podly/AlphaScore/hardware/AlphaScore - Modular PCB - 28PIN-SOP (300mil)/controller - back.png

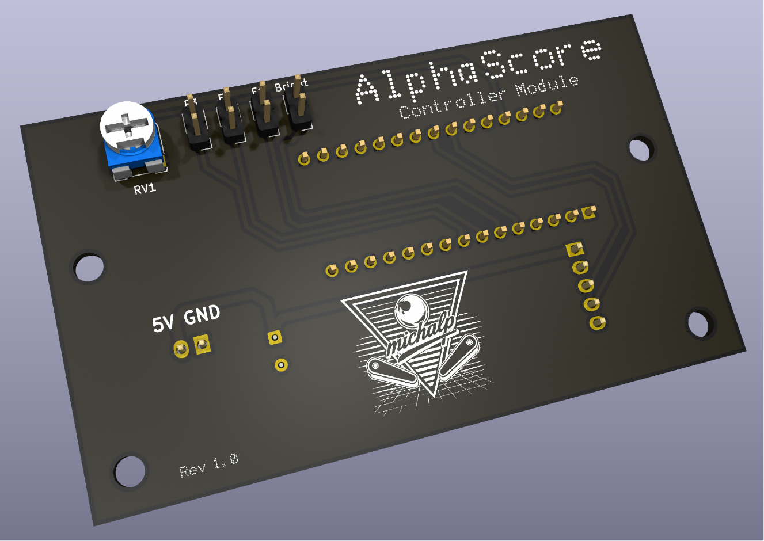
hardware/AlphaScore - Modular PCB - 28PIN-SOP (300mil)/controller - back.png
