podly/AlphaScore/hardware/AlphaScore - Modular PCB - 28PIN-SOP (300mil)/controller - front.png

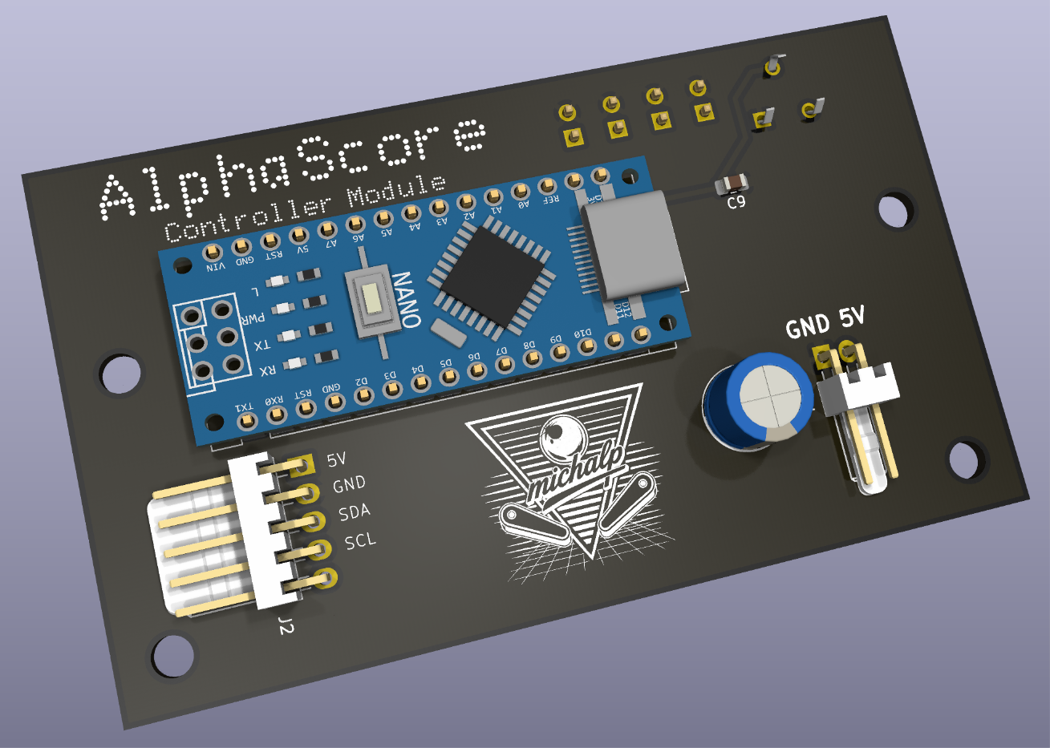
hardware/AlphaScore - Modular PCB - 28PIN-SOP (300mil)/controller - front.png
