podly/AlphaScore/hardware/AlphaScore - Modular PCB - 28PIN-SOP (300mil)/LED module - back.png

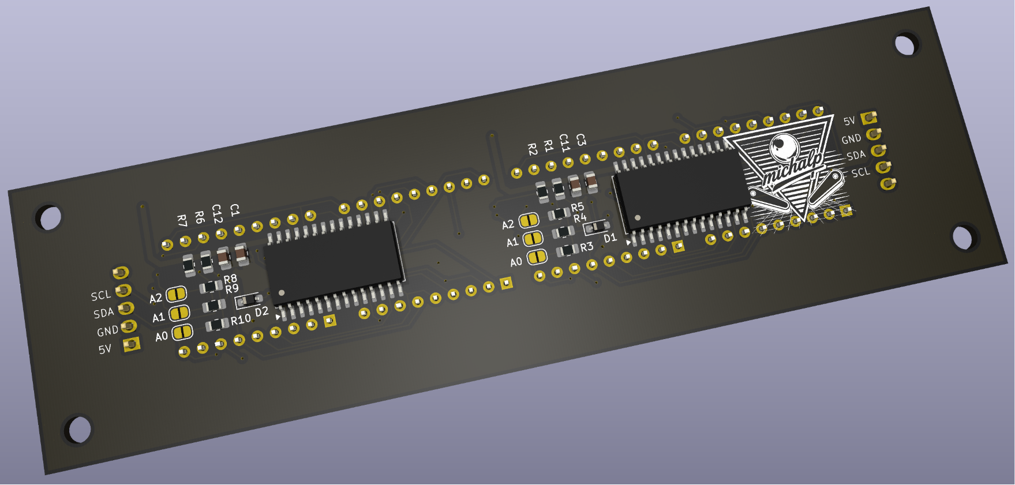
hardware/AlphaScore - Modular PCB - 28PIN-SOP (300mil)/LED module - back.png
