podly/AlphaScore/hardware/AlphaScore - Modular PCB - 28PIN-SOP (300mil)/LED module - front.png

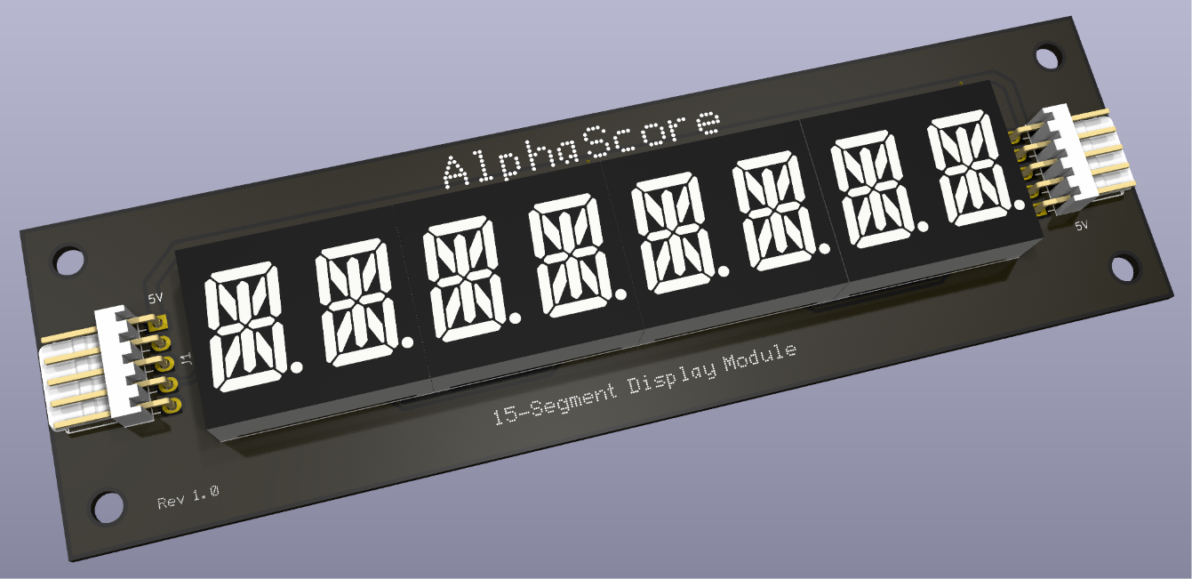
hardware/AlphaScore - Modular PCB - 28PIN-SOP (300mil)/LED module - front.png
