podly/AlphaScore/hardware/AlphaScore - Wide PCB - 28PIN-SOP (300mil)/Wide PCB - SOP28 (300mil) - back.png

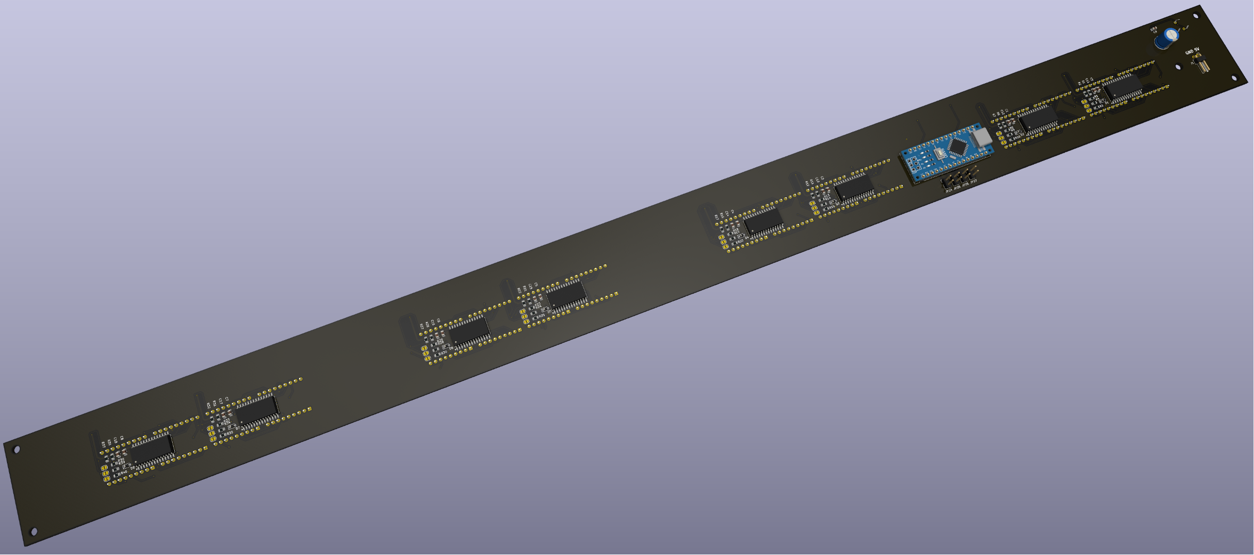
hardware/AlphaScore - Wide PCB - 28PIN-SOP (300mil)/Wide PCB - SOP28 (300mil) - back.png
