podly/AlphaScore/hardware/AlphaScore - Modular PCB - 28PIN-SOP (300mil)/AlphaScore - Modular PCB - controller module.pdf

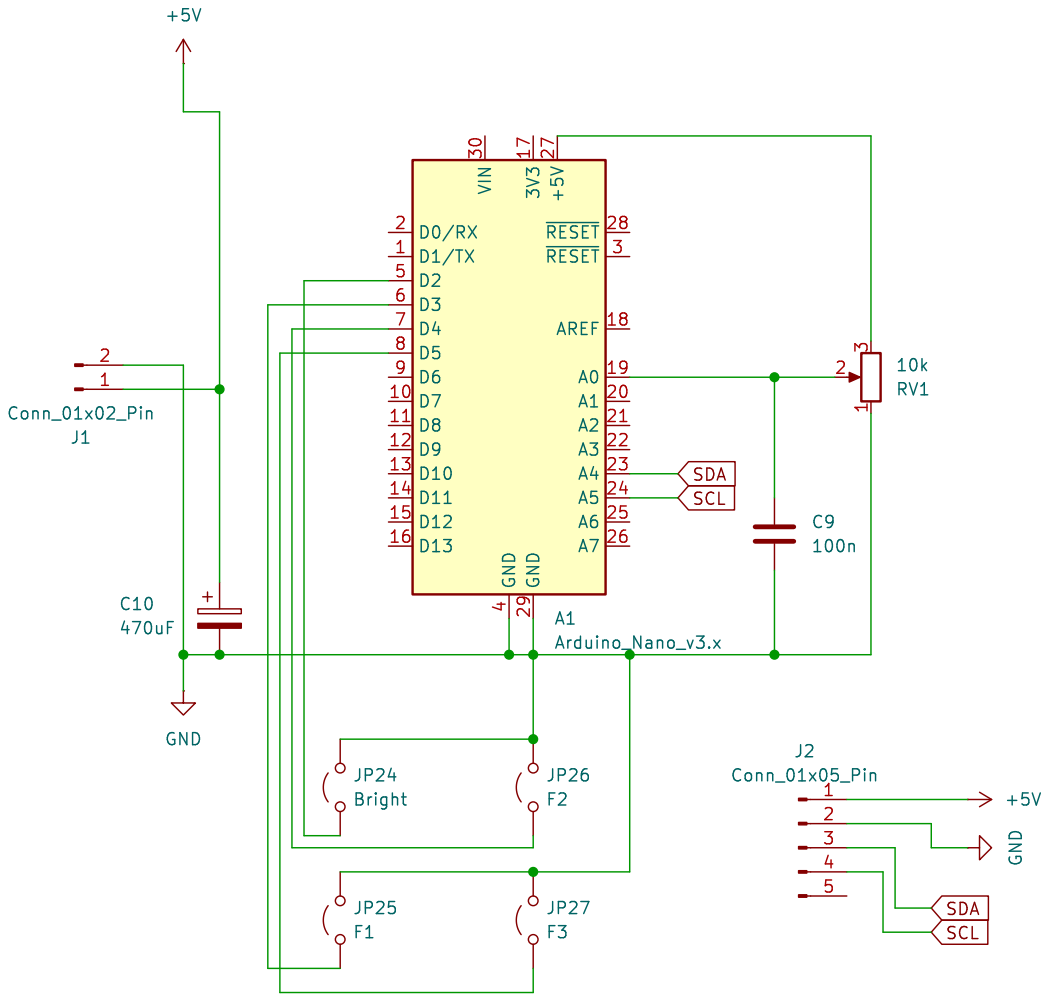
[picture p8: page 1]
