podly/AlphaScore/hardware/AlphaScore - Modular PCB - 28PIN-SOP (300mil)/AphaScore - Modular PCB - display module.pdf

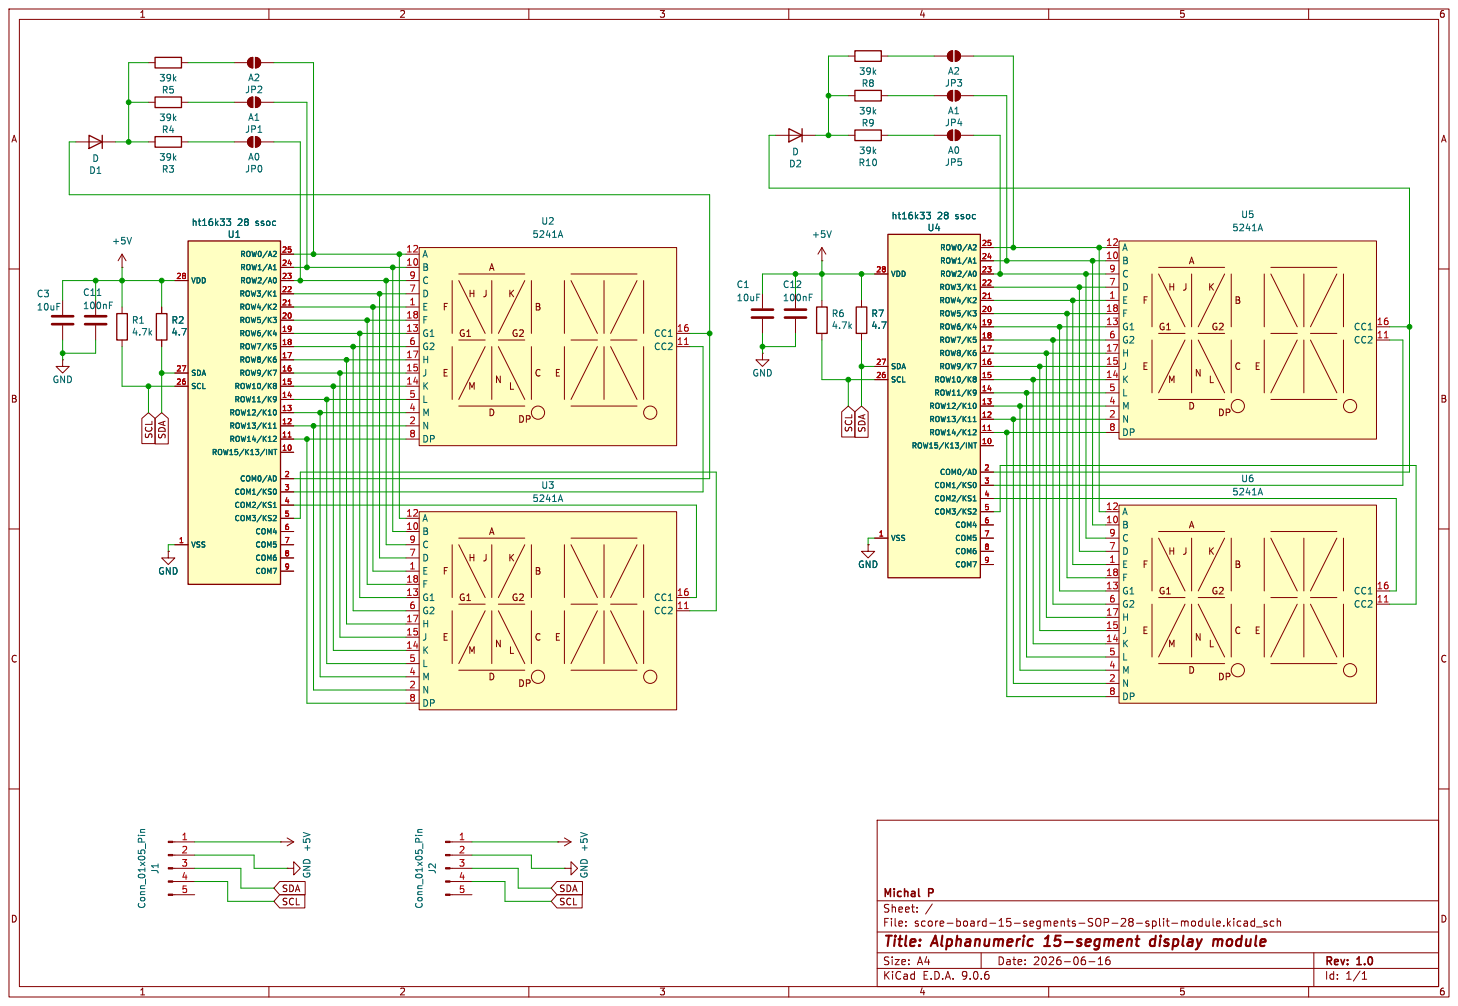
[picture p9: page 1]
