podly/AlphaScore/hardware/AlphaScore - Wide PCB - 28PIN-SOP (300mil)/AlphaScore - Wide PCB - schematic.pdf

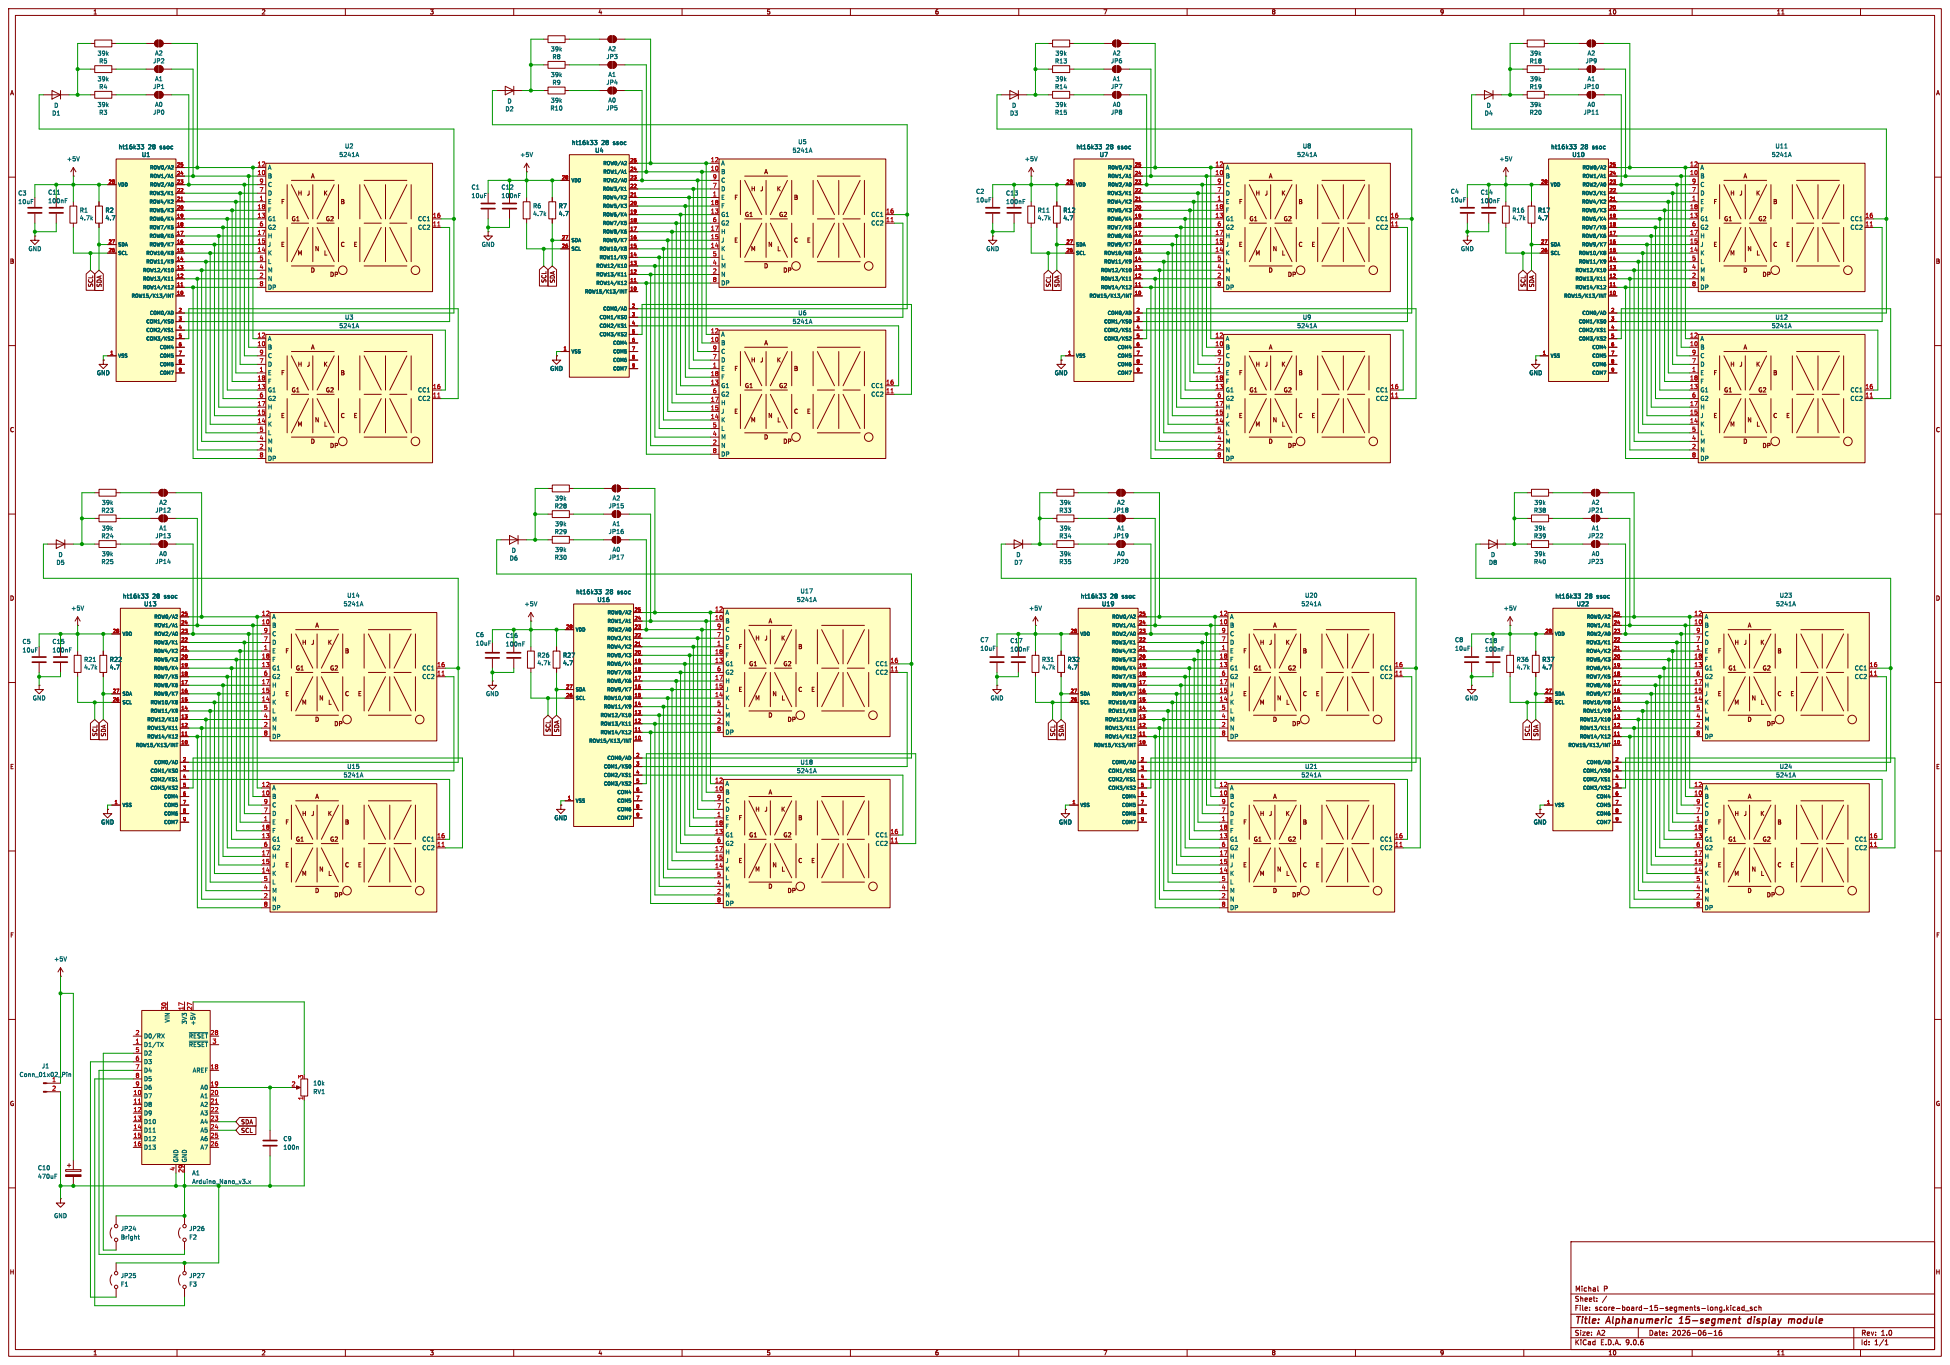
[picture p10: page 1]
