podly/AlphaScore/firmware/src/BrightnessController.h

/******************************************************************************
 * AlphaScore
 * ----------------------------------------------------------------------------
 * File:
 *     BrightnessController.h
 *
 * Description:
 *     Declares the analog display brightness controller.
 *
 * Copyright (c) 2026 Michal Podlejski
 *
 * SPDX-License-Identifier: MIT
 ******************************************************************************/

#pragma once

#include <Arduino.h>
#include "DisplayController.h"

class BrightnessController {
public:
  explicit BrightnessController(DisplayController &display);
  void begin();
  void update(bool force = false);

private:
  DisplayController &display_;
  unsigned long lastUpdate_ = 0;
  uint8_t currentBrightness_ = 255;
};
