podly/AlphaScore/firmware/src/SerialLineReader.h

/******************************************************************************
 * AlphaScore
 * ----------------------------------------------------------------------------
 * File:
 *     SerialLineReader.h
 *
 * Description:
 *     Declares the buffered UART line reader used by the command parser.
 *
 * Copyright (c) 2026 Michal Podlejski
 *
 * SPDX-License-Identifier: MIT
 ******************************************************************************/

#pragma once

#include <Arduino.h>

class SerialLineReader {
public:
  bool readLine(char *out, uint8_t outSize);

private:
  static constexpr uint8_t BufferSize = 96;
  char buffer_[BufferSize] = {};
  uint8_t pos_ = 0;
  bool overflow_ = false;
};
