podly/AlphaScore/firmware/src/App.h

/******************************************************************************
 * AlphaScore
 * ----------------------------------------------------------------------------
 * File:
 *     App.h
 *
 * Description:
 *     Declares the AlphaScore application setup and main-loop entry points.
 *
 * Copyright (c) 2026 Michal Podlejski
 *
 * SPDX-License-Identifier: MIT
 ******************************************************************************/

#pragma once

void appSetup();
void appLoop();
