podly/AlphaScore/(commit log)

2026-07-21 datasheets and schematics added
2026-07-21 added info about I2C addressing
2026-07-21 added i2c jumpers image
2026-07-22 BOM description
2026-07-22 BOM updated
2026-07-22 comment: Update Config.h to reserve JP25 pin for future use
2026-07-22 GERBER files
2026-07-22 PCB gerber files notes
2026-07-22 PIN HEADERs added
2026-07-23 added info about LED displays
